broncoracing/bspd-board/README.md

# BSPD 
Bronco Racing Brake System Plausibility Device for BREV25
