broncoracing/bspd-board/(commit log)

2024-11-05 CI/CD Changes
    [BSPD.kicad_sch, pots.kicad_sch, power.kicad_sch]
2024-11-15 update PCB file to new kicad version
    [BSPD.kicad_pcb]
2024-11-16 Initial Schematic and PCB changes for BR2025
    [BSPD.kicad_pcb, BSPD.kicad_sch, pots.kicad_sch, power.kicad_sch]
2024-11-16 Fixed deletion merge
    [BSPD.kicad_pcb, BSPD.kicad_sch]
2024-11-19 change pcb layout
    [BSPD.kicad_pcb, BSPD.kicad_sch]
2024-11-22 Small changes to silkscreen and fixed drc
    [BSPD.kicad_pcb, BSPD.kicad_sch]
2024-11-22 Design checklist changes
    [BSPD.kicad_pcb, BSPD.kicad_sch, pots.kicad_sch, power.kicad_sch]
2024-11-22 Remove lck files
    [BSPD.kicad_pcb, BSPD.kicad_sch]
2024-12-02 trace routing improvements and fixed inverter mistake
    [BSPD.kicad_pcb]
